alextrical/Teacup/Module T31/Module T31.kicad_pcb

## KiCad design Module T31/Module T31.kicad_pcb (2026-03-25)

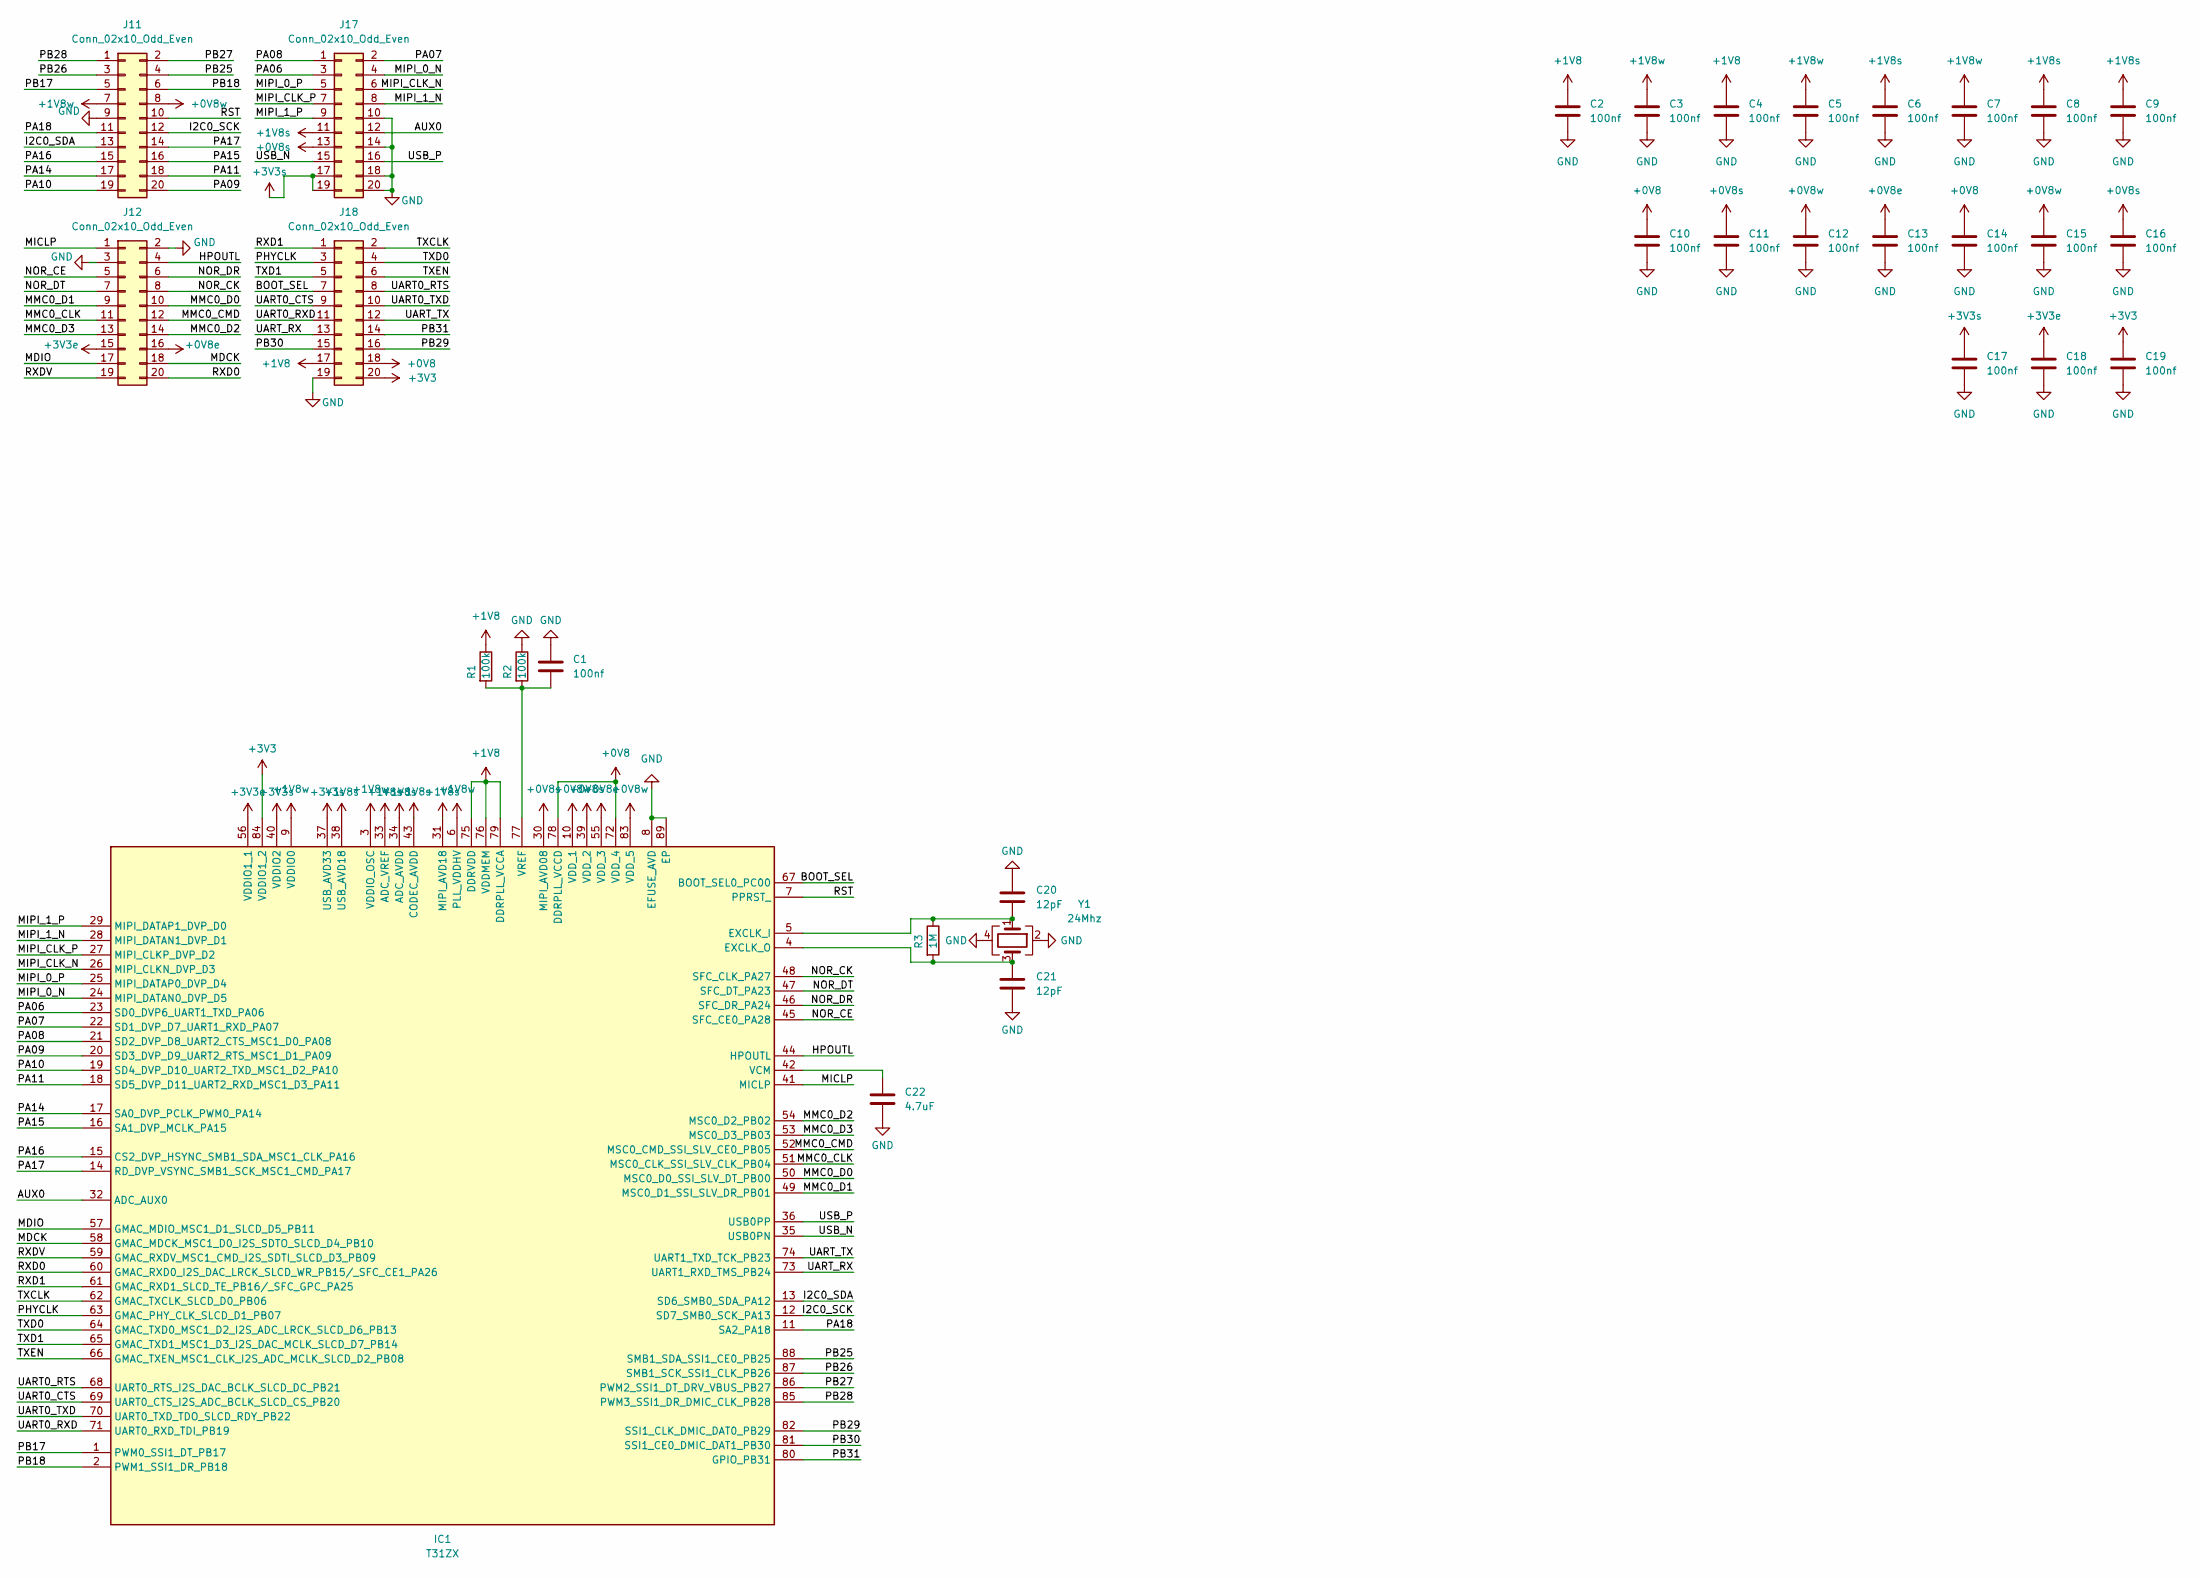
[picture p1: schematic Module T31.kicad_sch]

Parts:
C1, C2, C3, C4, C5, C6, C7, C8, C9, C10, C11, C12, C13, C14, C15, C16, C17, C18, C19: 100nf; C_0402_1005Metric; LCSC C1525
C20, C21: 12pF; C_0402_1005Metric; LCSC C1547
C22: 4.7uF; C_0402_1005Metric; LCSC C23733
IC1: T31ZX; QFN35P900X900X90-89N-D; Mouser Part Number 870-T31ZX
J11, J12, J17, J18: Conn_02x10_Odd_Even; PinHeader_2x10_P2.54mm_Vertical
R1, R2: 100k; R_0402_1005Metric; LCSC C25741
R3: 1M; R_0402_1005Metric; LCSC C26083
Y1: 24Mhz; Crystal_SMD_2016-4Pin_2.0x1.6mm; LCSC C557195

Connections:
+0V8: C10.1, C14.1, IC1.72 (VDD_4), IC1.78 (DDRPLL_VCCD), J18.18
+0V8e: C13.1, IC1.55 (VDD_3), J12.16
+0V8s: C11.1, C16.1, IC1.30 (MIPI_AVD08), IC1.39 (VDD_2), J17.13
+0V8w: C12.1, C15.1, IC1.10 (VDD_1), IC1.83 (VDD_5), J11.8
+1V8: C2.1, C4.1, IC1.75 (DDRVDD), IC1.76 (VDDMEM), IC1.79 (DDRPLL_VCCA), J18.17, R1.1
+1V8s: C6.1, C8.1, C9.1, IC1.31 (MIPI_AVD18), IC1.33 (ADC_VREF), IC1.34 (ADC_AVDD), IC1.38 (USB_AVD18), IC1.43 (CODEC_AVDD), J17.11
+1V8w: C3.1, C5.1, C7.1, IC1.3 (VDDIO_OSC), IC1.6 (PLL_VDDHV), IC1.9 (VDDIO0), J11.7
+3V3: C19.1, IC1.84 (VDDIO1_2), J18.20
+3V3e: C18.1, IC1.56 (VDDIO1_1), J12.15
+3V3s: C17.1, IC1.37 (USB_AVD33), IC1.40 (VDDIO2), J17.17, J17.19
/AUX0: IC1.32 (ADC_AUX0), J17.12
/BOOT_SEL: IC1.67 (BOOT_SEL0_PC00), J18.7
/HPOUTL: IC1.44 (HPOUTL), J12.4
/I2C0_SCK: IC1.12 (SD7_SMB0_SCK_PA13), J11.12
/I2C0_SDA: IC1.13 (SD6_SMB0_SDA_PA12), J11.13
/MDCK: IC1.58 (GMAC_MDCK_MSC1_D0_I2S_SDTO_SLCD_D4_PB10), J12.18
/MDIO: IC1.57 (GMAC_MDIO_MSC1_D1_SLCD_D5_PB11), J12.17
/MICLP: IC1.41 (MICLP), J12.1
/MIPI_0_N: IC1.24 (MIPI_DATAN0_DVP_D5), J17.4
/MIPI_0_P: IC1.25 (MIPI_DATAP0_DVP_D4), J17.5
/MIPI_1_N: IC1.28 (MIPI_DATAN1_DVP_D1), J17.8
/MIPI_1_P: IC1.29 (MIPI_DATAP1_DVP_D0), J17.9
/MIPI_CLK_N: IC1.26 (MIPI_CLKN_DVP_D3), J17.6
/MIPI_CLK_P: IC1.27 (MIPI_CLKP_DVP_D2), J17.7
/MMC0_CLK: IC1.51 (MSC0_CLK_SSI_SLV_CLK_PB04), J12.11
/MMC0_CMD: IC1.52 (MSC0_CMD_SSI_SLV_CE0_PB05), J12.12
/MMC0_D0: IC1.50 (MSC0_D0_SSI_SLV_DT_PB00), J12.10
/MMC0_D1: IC1.49 (MSC0_D1_SSI_SLV_DR_PB01), J12.9
/MMC0_D2: IC1.54 (MSC0_D2_PB02), J12.14
/MMC0_D3: IC1.53 (MSC0_D3_PB03), J12.13
/NOR_CE: IC1.45 (SFC_CE0_PA28), J12.5
/NOR_CK: IC1.48 (SFC_CLK_PA27), J12.8
/NOR_DR: IC1.46 (SFC_DR_PA24), J12.6
/NOR_DT: IC1.47 (SFC_DT_PA23), J12.7
/PA06: IC1.23 (SD0_DVP6_UART1_TXD_PA06), J17.3
/PA07: IC1.22 (SD1_DVP_D7_UART1_RXD_PA07), J17.2
/PA08: IC1.21 (SD2_DVP_D8_UART2_CTS_MSC1_D0_PA08), J17.1
/PA09: IC1.20 (SD3_DVP_D9_UART2_RTS_MSC1_D1_PA09), J11.20
/PA10: IC1.19 (SD4_DVP_D10_UART2_TXD_MSC1_D2_PA10), J11.19
/PA11: IC1.18 (SD5_DVP_D11_UART2_RXD_MSC1_D3_PA11), J11.18
/PA14: IC1.17 (SA0_DVP_PCLK_PWM0_PA14), J11.17
/PA15: IC1.16 (SA1_DVP_MCLK_PA15), J11.16
/PA16: IC1.15 (CS2_DVP_HSYNC_SMB1_SDA_MSC1_CLK_PA16), J11.15
/PA17: IC1.14 (RD_DVP_VSYNC_SMB1_SCK_MSC1_CMD_PA17), J11.14
/PA18: IC1.11 (SA2_PA18), J11.11
/PB17: IC1.1 (PWM0_SSI1_DT_PB17), J11.5
/PB18: IC1.2 (PWM1_SSI1_DR_PB18), J11.6
/PB25: IC1.88 (SMB1_SDA_SSI1_CE0_PB25), J11.4
/PB26: IC1.87 (SMB1_SCK_SSI1_CLK_PB26), J11.3
/PB27: IC1.86 (PWM2_SSI1_DT_DRV_VBUS_PB27), J11.2
/PB28: IC1.85 (PWM3_SSI1_DR_DMIC_CLK_PB28), J11.1
/PB29: IC1.82 (SSI1_CLK_DMIC_DAT0_PB29), J18.16
/PB30: IC1.81 (SSI1_CE0_DMIC_DAT1_PB30), J18.15
/PB31: IC1.80 (GPIO_PB31), J18.14
/PHYCLK: IC1.63 (GMAC_PHY_CLK_SLCD_D1_PB07), J18.3
/RST: IC1.7 (PPRST_), J11.10
/RXD0: IC1.60 (GMAC_RXD0_I2S_DAC_LRCK_SLCD_WR_PB15/_SF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), J12.20
/RXD1: IC1.61 (GMAC_RXD1_SLCD_TE_PB16/_SFC_GPC_PA25), J18.1
/RXDV: IC1.59 (GMAC_RXDV_MSC1_CMD_I2S_SDTI_SLCD_D3_PB09), J12.19
/TXCLK: IC1.62 (GMAC_TXCLK_SLCD_D0_PB06), J18.2
/TXD0: IC1.64 (GMAC_TXD0_MSC1_D2_I2S_ADC_LRCK_SLCD_D6_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), J18.4
/TXD1: IC1.65 (GMAC_TXD1_MSC1_D3_I2S_DAC_MCLK_SLCD_D7_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), J18.5
/TXEN: IC1.66 (GMAC_TXEN_MSC1_CLK_I2S_ADC_MCLK_SLCD_D2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), J18.6
/UART0_CTS: IC1.69 (UART0_CTS_I2S_ADC_BCLK_SLCD_CS_PB20), J18.9
/UART0_RTS: IC1.68 (UART0_RTS_I2S_DAC_BCLK_SLCD_DC_PB21), J18.8
/UART0_RXD: IC1.71 (UART0_RXD_TDI_PB19), J18.11
/UART0_TXD: IC1.70 (UART0_TXD_TDO_SLCD_RDY_PB22), J18.10
/UART_RX: IC1.73 (UART1_RXD_TMS_PB24), J18.13
/UART_TX: IC1.74 (UART1_TXD_TCK_PB23), J18.12
/USB_N: IC1.35 (USB0PN), J17.15
/USB_P: IC1.36 (USB0PP), J17.16
GND: C1.1, C2.2, C3.2, C4.2, C5.2, C6.2, C7.2, C8.2, C9.2, C10.2, C11.2, C12.2, C13.2, C14.2, C15.2, C16.2, C17.2, C18.2, C19.2, C20.1, C21.2, C22.2, IC1.8 (EFUSE_AVD), IC1.89 (EP), J11.9, J12.2, J12.3, J17.10, J17.14, J17.18, J17.20, J18.19, R2.1, Y1.2, Y1.4
unnamed: C20.2, IC1.5 (EXCLK_I), R3.1, Y1.1
unnamed: C21.1, IC1.4 (EXCLK_O), R3.2, Y1.3
unnamed: C22.1, IC1.42 (VCM)
unnamed: C1.2, IC1.77 (VREF), R1.2, R2.2

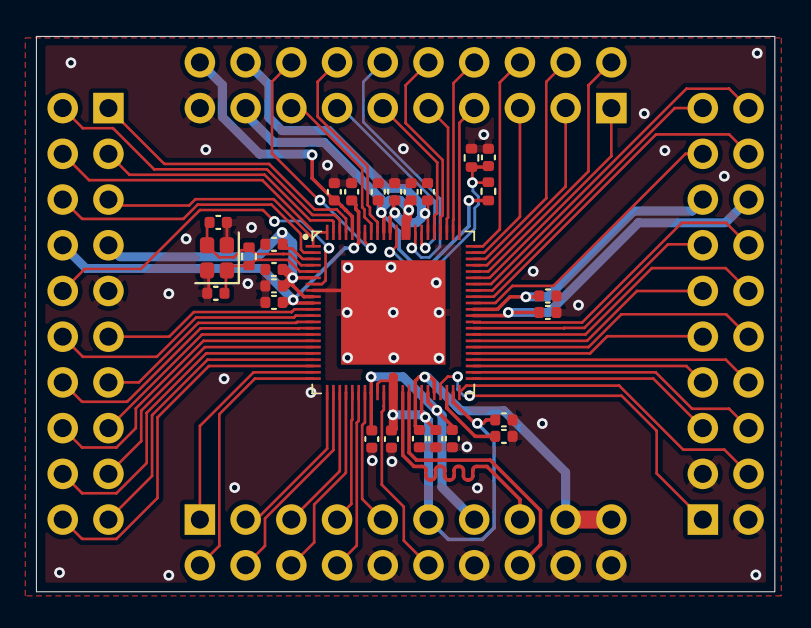
[picture p2: board Module T31.kicad_pcb from above]

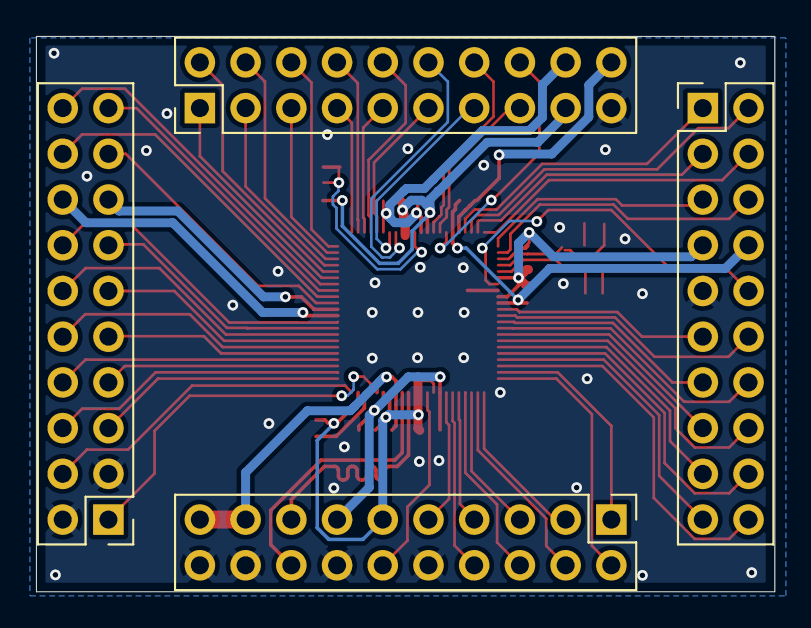
[picture p3: board Module T31.kicad_pcb from below]

Board: 4 copper layers, 41.0 x 30.8 mm, 31 parts (4 on the bottom side), 76 nets.
