alextrical/Teacup/Teacup.kicad_pcb

## KiCad design Teacup.kicad_pcb (2026-03-25)

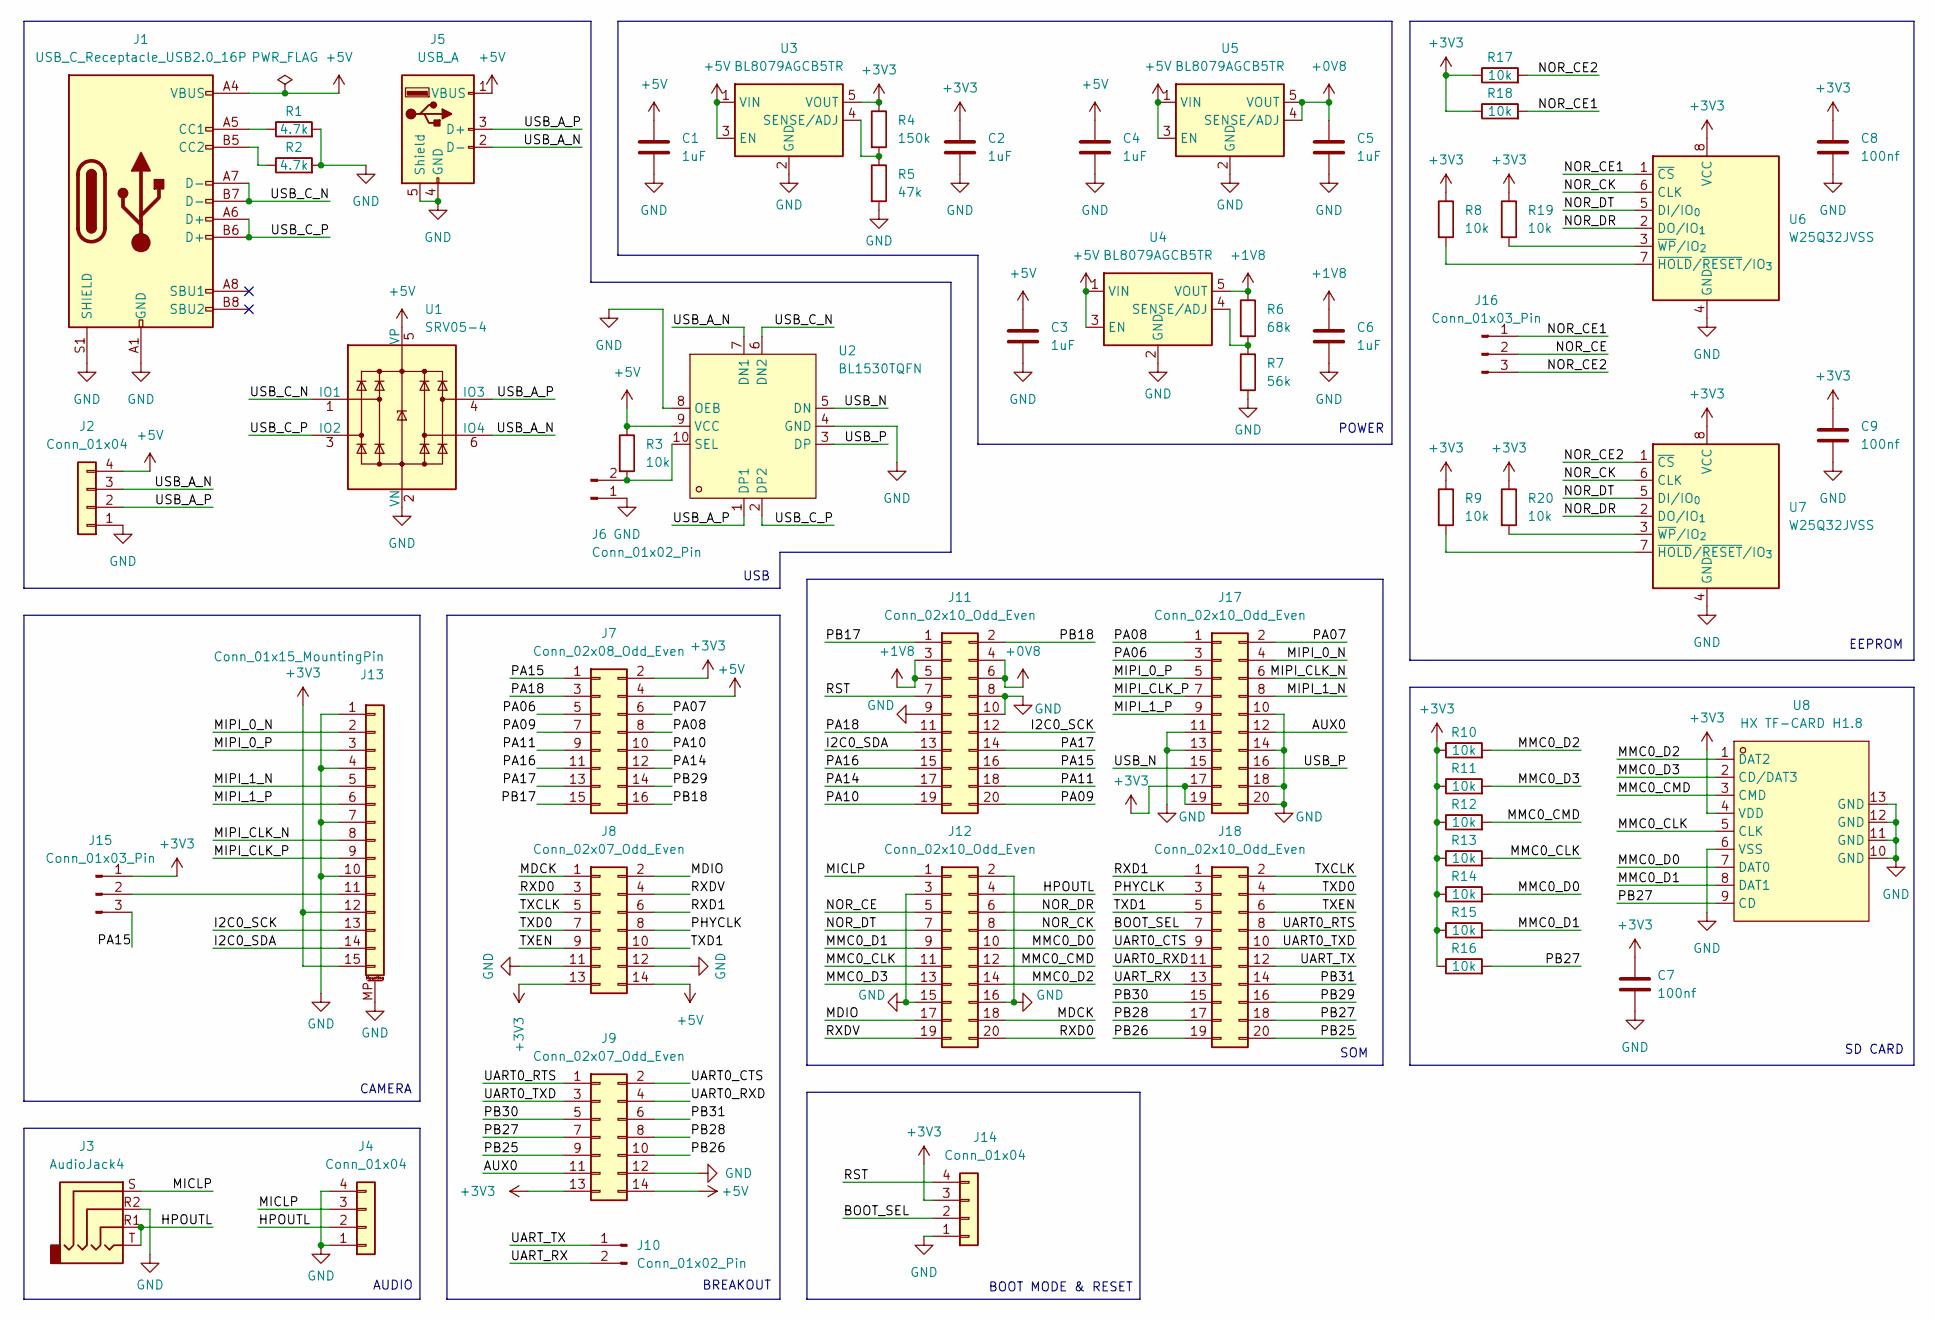
[picture p4: schematic Teacup.kicad_sch]

Parts:
C1, C2, C3, C4, C5, C6: 1uF; C_0402_1005Metric; LCSC C52923
C7, C8, C9: 100nf; C_0603_1608Metric; LCSC C14663
J1: USB_C_Receptacle_USB2.0_16P; USB_C_Receptacle_G-Switch_GT-USB-7010ASV; LCSC C36936538
J2, J4, J14: Conn_01x04; PinHeader_1x04_P2.54mm_Vertical
J3: AudioJack4; Jack_3.5mm_PJ320D_Horizontal
J5: USB_A; USB_A_Molex_67643_Horizontal
J6, J10: Conn_01x02_Pin; PinHeader_1x02_P2.54mm_Vertical
J7: Conn_02x08_Odd_Even; PinHeader_2x08_P2.54mm_Vertical
J8, J9: Conn_02x07_Odd_Even; PinHeader_2x07_P2.54mm_Vertical
J11, J12, J17, J18: Conn_02x10_Odd_Even; PinSocket_2x10_P2.54mm_Vertical
J13: Conn_01x15_MountingPin; JUSHUO_AFA07-S15FCA-00_1x15-1MP_P1.0mm_Horizontal
J15, J16: Conn_01x03_Pin; PinHeader_1x03_P2.54mm_Vertical
R1, R2: 4.7k; R_0402_1005Metric; LCSC C25900
R3, R8, R9, R10, R11, R12, R13, R14, R15, R16, R17, R18, R19, R20: 10k; R_0402_1005Metric; LCSC C25744
R4: 150k; R_0603_1608Metric; LCSC C22807
R5: 47k; R_0402_1005Metric; LCSC C25792
R6: 68k; R_0603_1608Metric; LCSC C23231
R7: 56k; R_0603_1608Metric; LCSC C23206
U1: SRV05-4; SOT-23-6; LCSC C7420376
U2: BL1530TQFN; UTQFN-10L_L1.8-W1.4-P0.40-BL; LCSC Part C313543
U3, U4, U5: BL8079AGCB5TR; TSOT-23-5; LCSC C5291411
U6: W25Q32JVSS; DIP-8_W7.62mm_Socket
U7: W25Q32JVSS; SOIC-8_5.3x5.3mm_P1.27mm
U8: HX TF-CARD H1.8; TF-SMD_HX-TF-CARD-H1.8-SY; LCSC Part C19189036

Connections:
+0V8: C5.1, J11.4, J11.6, U5.4 (SENSE/ADJ), U5.5 (VOUT)
+1V8: C6.1, J11.3, J11.5, R6.1, U4.5 (VOUT)
+3V3: C2.1, C7.1, C8.1, C9.1, J7.2, J8.13, J9.13, J13.12, J13.15, J14.3, J15.1, J17.17, J17.19, R4.1, R8.1, R9.1, R10.1, R11.1, R12.1, R13.1, R14.1, R15.1, R16.1, R17.1, R18.1, R19.1, R20.1, U3.5 (VOUT), U6.8 (VCC), U7.8 (VCC), U8.4 (VDD)
+5V: C1.1, C3.1, C4.1, J1.A4 (VBUS), J1.A9 (VBUS), J1.B4 (VBUS), J1.B9 (VBUS), J2.4, J5.1 (VBUS), J7.4, J8.14, J9.14, R3.1, U1.5 (VP), U2.9 (VCC), U3.1 (VIN), U3.3 (EN), U4.1 (VIN), U4.3 (EN), U5.1 (VIN), U5.3 (EN)
/AUX0: J9.11, J17.12
/BOOT_SEL: J14.2, J18.7
/HPOUTL: J3.R1, J3.T, J4.2, J12.4
/I2C0_SCK: J11.12, J13.13
/I2C0_SDA: J11.13, J13.14
/MDCK: J8.1, J12.18
/MDIO: J8.2, J12.17
/MICLP: J3.S, J4.3, J12.1
/MIPI_0_N: J13.2, J17.4
/MIPI_0_P: J13.3, J17.5
/MIPI_1_N: J13.5, J17.8
/MIPI_1_P: J13.6, J17.9
/MIPI_CLK_N: J13.8, J17.6
/MIPI_CLK_P: J13.9, J17.7
/MMC0_CLK: J12.11, R13.2, U8.5 (CLK)
/MMC0_CMD: J12.12, R12.2, U8.3 (CMD)
/MMC0_D0: J12.10, R14.2, U8.7 (DAT0)
/MMC0_D1: J12.9, R15.2, U8.8 (DAT1)
/MMC0_D2: J12.14, R10.2, U8.1 (DAT2)
/MMC0_D3: J12.13, R11.2, U8.2 (CD/DAT3)
/NOR_CE: J12.5, J16.2
/NOR_CE1: J16.1, R18.2, U6.1 (~CS)
/NOR_CE2: J16.3, R17.2, U7.1 (~CS)
/NOR_CK: J12.8, U6.6 (CLK), U7.6 (CLK)
/NOR_DR: J12.6, U6.2 (DO/IO_{1}), U7.2 (DO/IO_{1})
/NOR_DT: J12.7, U6.5 (DI/IO_{0}), U7.5 (DI/IO_{0})
/PA06: J7.5, J17.3
/PA07: J7.6, J17.2
/PA08: J7.8, J17.1
/PA09: J7.7, J11.20
/PA10: J7.10, J11.19
/PA11: J7.9, J11.18
/PA14: J7.12, J11.17
/PA15: J7.1, J11.16, J15.3
/PA16: J7.11, J11.15
/PA17: J7.13, J11.14
/PA18: J7.3, J11.11
/PB17: J7.15, J11.1
/PB18: J7.16, J11.2
/PB25: J9.9, J18.20
/PB26: J9.10, J18.19
/PB27: J9.7, J18.18, R16.2, U8.9 (CD)
/PB28: J9.8, J18.17
/PB29: J7.14, J18.16
/PB30: J9.5, J18.15
/PB31: J9.6, J18.14
/PHYCLK: J8.8, J18.3
/RST: J11.7, J14.4
/RXD0: J8.3, J12.20
/RXD1: J8.6, J18.1
/RXDV: J8.4, J12.19
/TXCLK: J8.5, J18.2
/TXD0: J8.7, J18.4
/TXD1: J8.10, J18.5
/TXEN: J8.9, J18.6
/UART0_CTS: J9.2, J18.9
/UART0_RTS: J9.1, J18.8
/UART0_RXD: J9.4, J18.11
/UART0_TXD: J9.3, J18.10
/UART_RX: J10.2, J18.13
/UART_TX: J10.1, J18.12
/USB_A_N: J2.3, J5.2 (D-), U1.6 (IO4), U2.7 (DN1)
/USB_A_P: J2.2, J5.3 (D+), U1.4 (IO3), U2.1 (DP1)
/USB_C_N: J1.A7 (D-), J1.B7 (D-), U1.1 (IO1), U2.6 (DN2)
/USB_C_P: J1.A6 (D+), J1.B6 (D+), U1.3 (IO2), U2.2 (DP2)
/USB_N: J17.15, U2.5 (DN)
/USB_P: J17.16, U2.3 (DP)
GND: C1.2, C2.2, C3.2, C4.2, C5.2, C6.2, C7.2, C8.2, C9.2, J1.A1 (GND), J1.A12 (GND), J1.B1 (GND), J1.B12 (GND), J1.S1 (SHIELD), J2.1, J3.R2, J4.1, J4.4, J5.4 (GND), J5.5 (Shield), J6.1, J8.11, J8.12, J9.12, J11.8, J11.9, J11.10, J12.2, J12.3, J12.15, J12.16, J13.1, J13.4, J13.7, J13.10, J13.MP (MountPin), J14.1, J17.10, J17.11, J17.13, J17.14, J17.18, J17.20, R1.2, R2.2, R5.2, R7.2, U1.2 (VN), U2.4 (GND), U2.8 (OEB), U3.2 (GND), U4.2 (GND), U5.2 (GND), U6.4 (GND), U7.4 (GND), U8.6 (VSS), U8.10 (GND), U8.11 (GND), U8.12 (GND), U8.13 (GND)
unnamed: J1.A5 (CC1), R1.1
unnamed: J1.B5 (CC2), R2.1
unnamed: J6.2, R3.2, U2.10 (SEL)
unnamed: J13.11, J15.2
unnamed: R4.2, R5.1, U3.4 (SENSE/ADJ)
unnamed: R6.2, R7.1, U4.4 (SENSE/ADJ)
unnamed: R8.2, U6.7 (~HOLD/~RESET/IO_{3})
unnamed: R19.2, U6.3 (~WP/IO_{2})
unnamed: R9.2, U7.7 (~HOLD/~RESET/IO_{3})
unnamed: R20.2, U7.3 (~WP/IO_{2})

Notes on the sheet:
SOM
BOOT MODE & RESET
EEPROM
POWER
SD CARD
CAMERA
BREAKOUT
AUDIO
USB

Board: 2 copper layers, 55 parts (0 on the bottom side), 82 nets, no tracks yet.
